ahpohl/pulsemeter/(commit log)

2019-05-14 sensor and rrd methods
2019-05-22 printing raw sensor values works
2019-05-23 added arduino sketch
2019-05-23 command received, but response error
    [pulse.cpp, pulsemeter.ino]
2019-05-24 setting command on sensor does not work
    [main.cpp, pulse.cpp, pulsemeter.ino]
2019-05-24 arduino send command just once
2019-05-25 major code cleanup, todo: sync error, error handling
    [cobs.cpp, main.cpp, pulse.cpp, pulsemeter.ino]
2019-05-25 wrong decoded packet length, pulse.cpp:244
    [pulse.cpp, pulsemeter.ino]
2019-05-26 read raw sensor values ok, todo: process response, trigger mode
2019-05-26 mode switch works, not reliable
2019-05-27 todo: synchronise with Arduino
2019-05-27 sync issue fixed, mode switch works reliably
    [main.cpp, pulse.cpp, pulsemeter.ino]
2019-05-28 add serial device parameter
2019-05-28 fix sensor reading signed int
    [comm.cpp]
2019-05-28 arduino sketch switch led on / off
2019-05-28 program arduino from odroid, prog.sh
2019-05-31 todo: redesign the rrd schema (counts / counts per second
    [comm.cpp, main.cpp, rrd.cpp]
2019-06-01 added serial device lock, todo: check serial sync
2019-06-01 remove serial device lock
2019-06-01 enabled serial lock, todo: fix sync issue after ctrl-c
    [comm.cpp]
2019-06-02 fixed sync bug by adding sleep(2), why?
    [comm.cpp]
2019-06-05 added sensor.log debug output
2019-06-06 declare rrd headers extern C
    [sensor.ods, sensor2.ods]
2019-06-07 arduino getSensorValue without delay func
2019-06-07 add cached parameter
    [sensor.ods]
2019-06-08 compile with threads support
2019-06-09 trigger create daemon thread
2019-06-09 created trigger thread, todo: how to pass private member variables
2019-06-12 added pvoutput script and systemd timer
2019-06-13 pvoutput.sh includes power output, value does not make sense
2019-06-13 arduino: set trigger mode lcd output
2019-06-14 fix pvoutput.sh power calculation
2019-06-22 temporary remove thread code
2019-06-22 invert sensor trigger signal
    [pulsemeter.ino]
2019-06-23 verify power calculation spreadsheet
    [sensor3.ods]
2019-06-24 fetch energy and power, todo: investigate rrd_value_t
2019-06-24 sensor.ods first derivative
    [sensor.ods]
2019-06-25 use rrd_xport to get energy and power, todo: timestamp
2019-06-26 get energy and power using rrd_xport
2019-06-26 get energy and power with rrd_xport
2019-06-28 arduino: get min and max sensor values
    [sensor.ods]
2019-06-29 arduino auto adjust trigger levels
2019-06-29 arduino: use lock symbol
2019-06-29 arduino: added more comments
2019-06-29 arduino: fix lcd line length
    [pulsemeter.ino]
2019-07-01 upload to pvoutput, todo: curl error handling
    [main.cpp, pulse.cpp, pvoutput.cpp, rrd.cpp]
2019-07-01 added pvoutput error handling
    [main.cpp, pvoutput.cpp]
2019-07-02 upload to pvoutput working, using systemd timer
2019-07-03 no compile errors, todo: check for non-sense
    [comm.cpp, main.cpp, pulse.cpp, pulse.hpp, pvoutput.cpp, rrd.cpp]
2019-07-06 trigger and pvoutput running in separate threads
2019-07-06 reduce number of defined threads
2019-07-07 rework of trigger mode logic, WIP
    [comm.cpp, main.cpp, pulse.cpp, pulse.hpp, pvoutput.cpp, rrd.cpp]
2019-07-08 fixed comile error function missing
    [rrd.cpp]
2019-07-11 calc energy,power manually and log to file
2019-07-13 flush deamon before count update, avoid non-zero return value
    [rrd.cpp]
2019-07-14 log sensor triggers to pulse.log
2019-07-14 calculate energy and power in pulse.log
2019-07-14 enable pulse.log, power equals zero on startup
2019-07-14 fix power calculation
2019-07-15 pvoutput.cpp switch back to rrd xport method
2019-07-16 fix rrdc_update multiple connections
    [rrd.cpp]
2019-07-16 fix int and floating point types calc
    [pvoutput.cpp, rrd.cpp]
2019-07-19 move upload timer to runPVoutput()
2019-07-19 check power for nan
2019-07-20 do not check power for nan
2019-07-20 cleanup resources
    [sensor.ods, sensor2.ods, sensor3.ods]
2019-08-05 add schematic png
2019-08-30 add raw sensor plot
2019-08-30 insert figures
2019-08-31 depend on rrdcached.socket
